shuki25/smart-chessboard-controller/pdf/smart-chessboard-controller.pdf

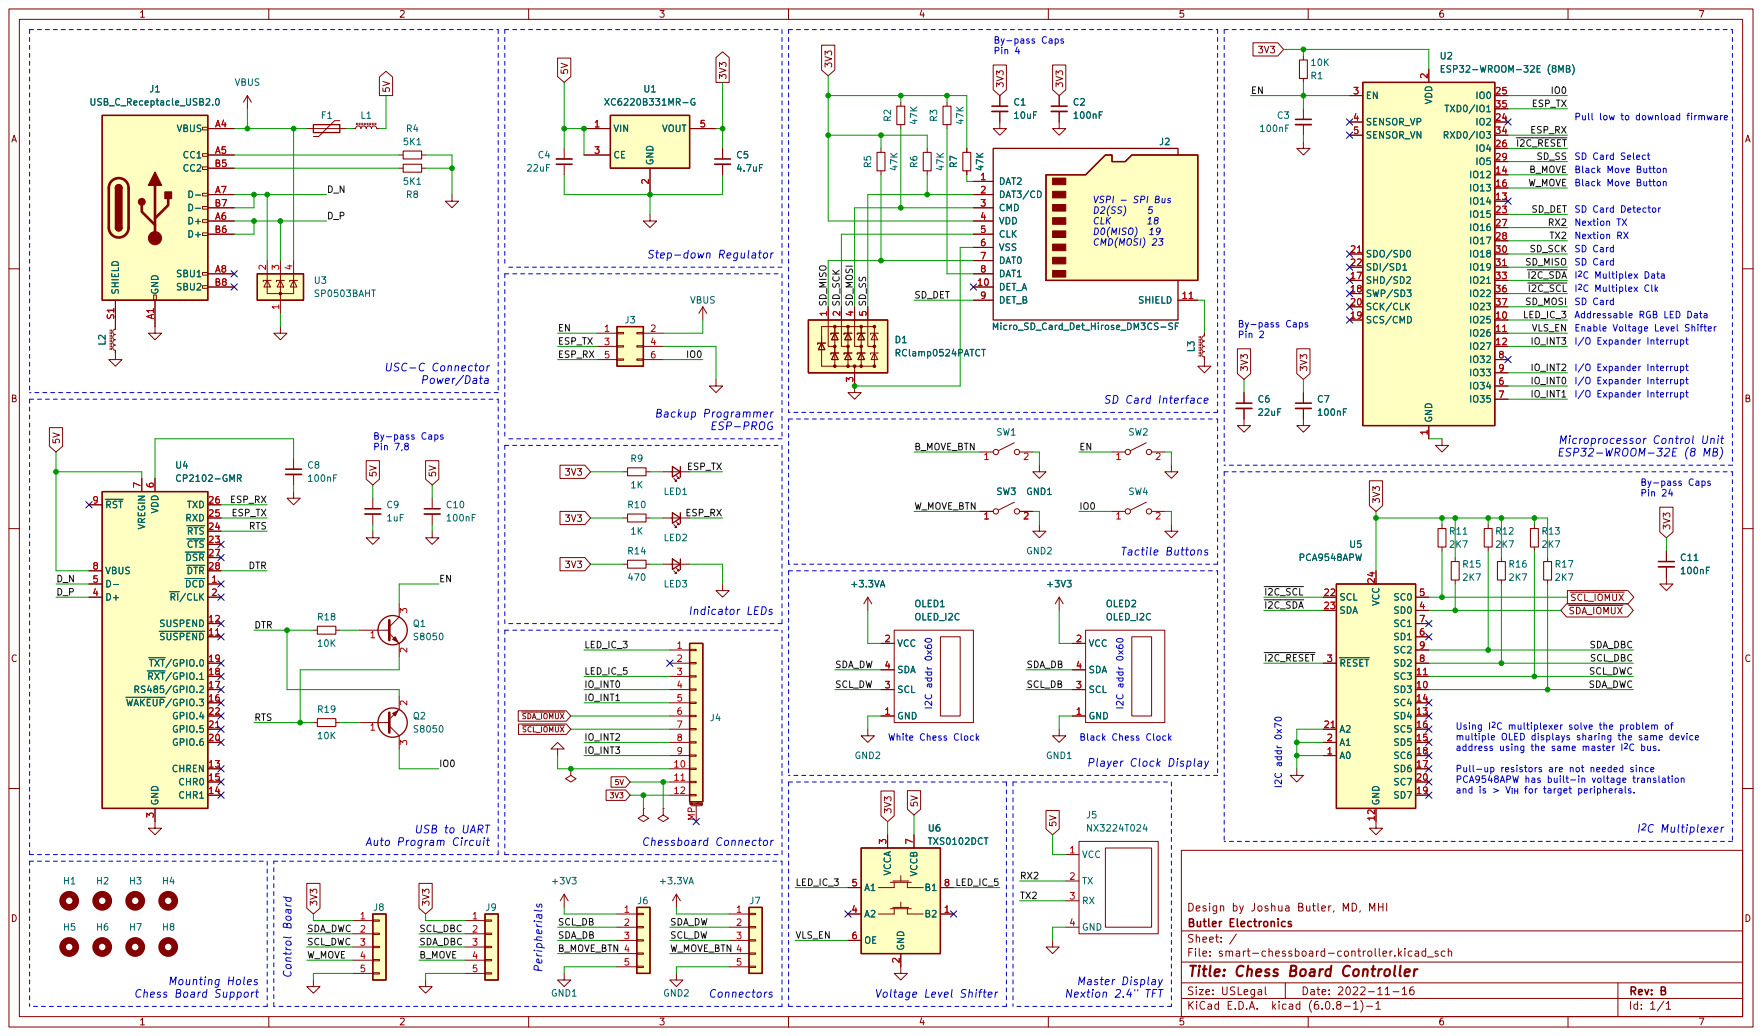
[picture p1: page 1]

2 SCK/CLK 20 SDO/SD0 21 SDI/SD1 22

By-pass Caps Pin 24 Black Move Button I2C addr 0x60

SD Card Chessboard Connector
Step-down Regulator

4 U3SP0503BAHT A0 1 SD3 10 SC3 11 GND 12 SD4 13 SC4 14 SD5 15 SC5 16 SD6 17 SC6 18 SD7 19 A1 2 SC7 20 A2 21 SCL 22 SDA 23 VCC 24

I^{2}C Multiplex Clk
I/O Expander Interrupt SD Card

Enable Voltage Level Shifter
I/O Expander Interrupt

Backup Programmer ESP-PROG

7 B1 8 OLED1 OLED_I2C GND 1 VCC 2 SCL 3 SDA 4 U5 PCA9548APW
+3.3VA GND2

IO_INT3 EN

Using I^{2}C multiplexer solve the problem of
multiple OLED displays sharing the same device
address using the same master I^{2}C bus.

Pull-up resistors are not needed since
PCA9548APW has built-in voltage translation
and is > V_{iH} for target peripherals.

Chess Board Support | +3V3

D Date: 2022-11-16 KiCad E.D.A. kicad (6.0.8-1)-1
File: smart-chessboard-controller.kicad_sch Sheet: / Butler Electronics

Id: 1/1 Title: Chess Board Controller
