shuki25/smart-chessboard-controller/smart-chessboard-controller.kicad_pcb

## KiCad design smart-chessboard-controller.kicad_pcb (2022-12-08)

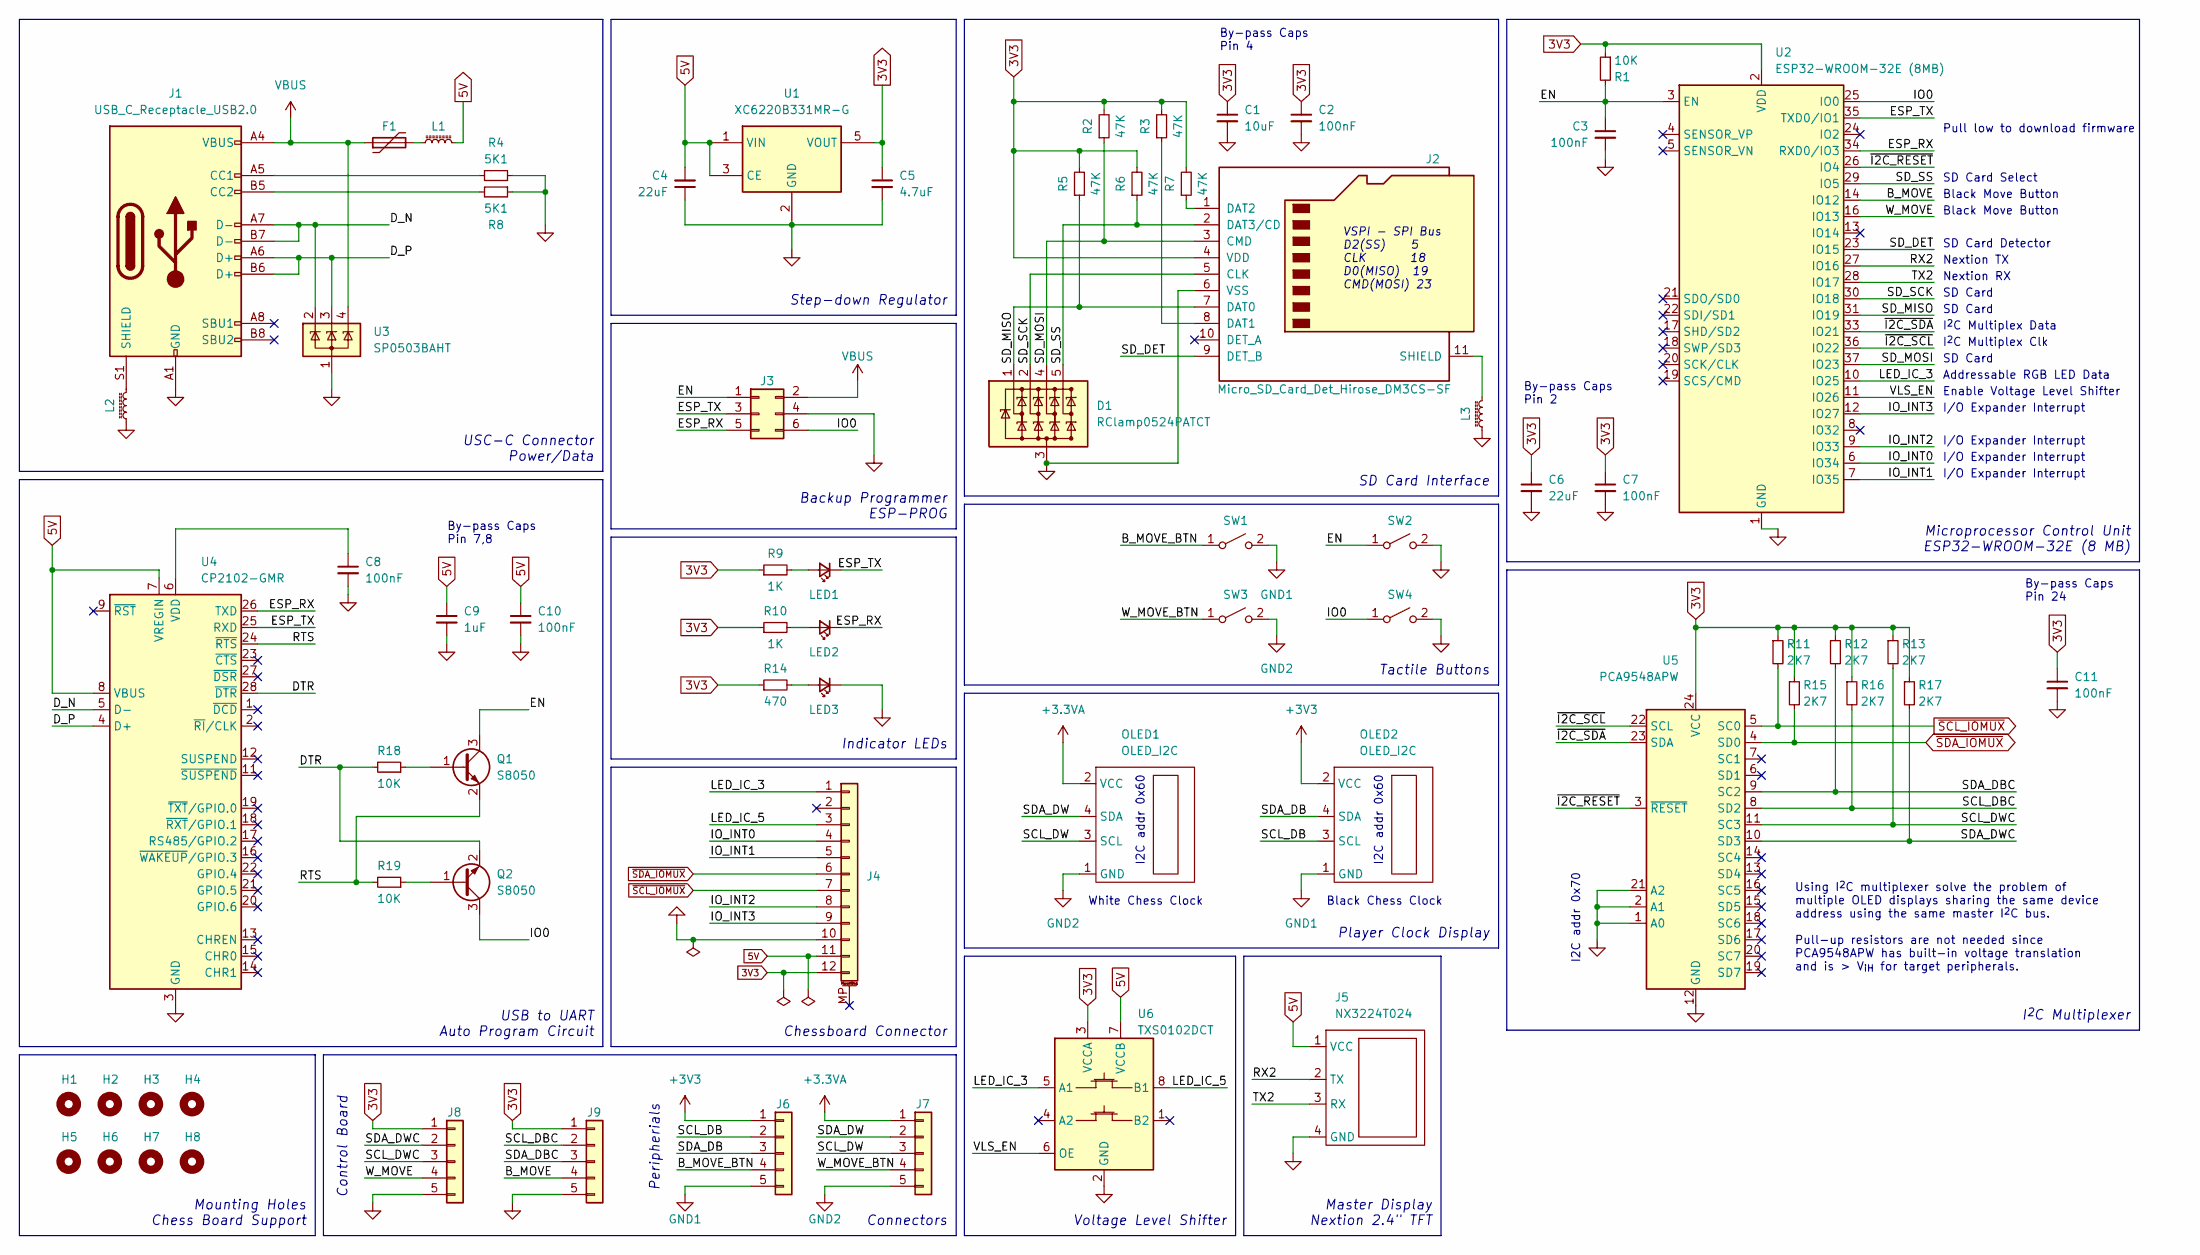
[picture p2: schematic smart-chessboard-controller.kicad_sch, Chess Board Controller]

Parts:
C1: 10uF; C_0603_1608Metric; LCSC C19702
C2, C3, C7, C8, C10, C11: 100nF; C_0603_1608Metric; LCSC C14663
C4, C6: 22uF; C_0603_1608Metric; LCSC C59461
C5: 4.7uF; C_0603_1608Metric; LCSC C19666
C9: 1uF; C_0603_1608Metric; LCSC C14663
D1: RClamp0524PATCT; SLP2510P8; LCSC C40960
F1: C207047; Fuse_1210_3225Metric; LCSC C135353
H1, H2, H3, H4, H5, H6, H7, H8: MountingHole; MountingHole_2.7mm_M2.5_DIN965_Pad_TopBottom
J1: USB_C_Receptacle_USB2.0; USB_C_Receptable_918-418K2023S40001; LCSC C167321
J2: Micro_SD_Card_Det_Hirose_DM3CS-SF; DM3CS-SF; LCSC C202111
J3: Conn_02x03_Odd_Even; TC2030-IDC-NL
J4: Conn_01x12_MountingPin; TE_1-84953-2_1x12-1MP_P1.0mm_Horizontal; LCSC C262718
J5: NX3224T024; JST_PH_S4B-PH-K_1x04_P2.00mm_Horizontal; LCSC C157926
J6, J7, J8, J9: Conn_01x05; JST_PH_S5B-PH-K_1x05_P2.00mm_Horizontal; LCSC C157923
L1: L_Ferrite_Small; L_0805_2012Metric_Pad1.15x1.40mm_HandSolder; LCSC C61012
L2, L3: L_Ferrite_Small; L_0603_1608Metric; LCSC C113018
LED1: BLUE; LED_0603_1608Metric; LCSC C72041
LED2: GREEN; LED_0603_1608Metric; LCSC C72043
LED3: RED; LED_0603_1608Metric; LCSC C2286
OLED1, OLED2: OLED_I2C; OLED_128x32_I2C_4pins
Q1, Q2: S8050; SOT-23; LCSC C2146
R1, R18, R19: 10K; R_0603_1608Metric; LCSC C25804
R2, R3, R5, R6, R7: 47K; R_0603_1608Metric; LCSC C25819
R4, R8: 5K1; R_0805_2012Metric; LCSC C27834
R9, R10: 1K; R_0603_1608Metric; LCSC C21190
R11, R12, R13, R15, R16, R17: 2K7; R_0603_1608Metric; LCSC C13167
R14: 470; R_0603_1608Metric; MFR_PART_NBR 0805W8F4700T5E; LCSC C23179
SW1, SW3: SW_SPST; Button_SW_12mm_1.8mm_hole; LCSC C84931
SW2, SW4: SW_SPST; XKB-Connectivity-TS-1187A-B-A-B; LCSC C318884
U1: XC6220B331MR-G; SOT-23-5; LCSC C86534
U2: ESP32-WROOM-32E (8MB); ESP32-WROOM-32; LCSC C701342
U3: SP0503BAHT; SOT-143-4; LCSC C7074
U4: CP2102-GMR; QFN-28-1EP_5x5mm_P0.5mm_EP3.35x3.35mm; LCSC C6568
U5: PCA9548APW; TSSOP-24_4.4x7.8mm_P0.65mm; LCSC C21198
U6: TXS0102DCT; SSOP-8_2.95x2.8mm_P0.65mm; LCSC C324082

Connections:
3V3: C1.1, C2.1, C5.1, C6.1, C7.1, C11.1, J2.4 (VDD), J4.12, J8.1, J9.1, R1.1, R2.2, R3.2, R5.2, R6.2, R7.2, R9.1, R10.1, R11.1, R12.1, R13.1, R14.1, R15.1, R16.1, R17.1, U1.5 (VOUT), U2.2 (VDD), U5.24 (VCC), U6.3 (VCCA)
5V: C4.2, C9.1, C10.1, J4.11, J5.1 (VCC), L1.2, U1.1 (VIN), U1.3 (CE), U4.7 (VREGIN), U4.8 (VBUS), U6.7 (VCCB)
+3.3VA: J7.1, OLED1.2 (VCC)
+3V3: J6.1, OLED2.2 (VCC)
/B_MOVE: J9.4, U2.14 (IO12)
/B_MOVE_BTN: J6.4, SW1.1 (A)
/DTR: Q2.2 (E), R18.2, U4.28 (~DTR)
/D_N: J1.A7 (D-), J1.B7 (D-), U3.2 (K), U4.5 (D-)
/D_P: J1.A6 (D+), J1.B6 (D+), U3.3 (K), U4.4 (D+)
/EN: C3.1, J3.1, Q1.3 (C), R1.2, SW2.1 (A), U2.3 (EN)
/ESP_RX: J3.5, LED2.1 (K), U2.34 (RXD0/IO3), U4.26 (TXD)
/ESP_TX: J3.3, LED1.1 (K), U2.35 (TXD0/IO1), U4.25 (RXD)
/IO0: J3.6, Q2.3 (C), SW4.1 (A), U2.25 (IO0)
/IO_INT0: J4.4, U2.6 (IO34)
/IO_INT1: J4.5, U2.7 (IO35)
/IO_INT2: J4.8, U2.9 (IO33)
/IO_INT3: J4.9, U2.12 (IO27)
/LED_IC_3: J4.1, U2.10 (IO25), U6.5 (A1)
/LED_IC_5: J4.3, U6.8 (B1)
/RTS: Q1.2 (E), R19.2, U4.24 (~RTS)
/RX2: J5.2 (TX), U2.27 (IO16)
/SCL_DB: J6.2, OLED2.3 (SCL)
/SCL_DBC: J9.2, R16.2, U5.8 (SD2)
/SCL_DW: J7.3, OLED1.3 (SCL)
/SCL_DWC: J8.3, R13.2, U5.11 (SC3)
/SDA_DB: J6.3, OLED2.4 (SDA)
/SDA_DBC: J9.3, R12.2, U5.9 (SC2)
/SDA_DW: J7.2, OLED1.4 (SDA)
/SDA_DWC: J8.2, R17.2, U5.10 (SD3)
/SD_DET: J2.9 (DET_B), U2.23 (IO15)
/SD_MISO: D1.1 (K1), J2.7 (DAT0), R5.1, U2.31 (IO19)
/SD_MOSI: D1.4 (K3), J2.3 (CMD), R2.1, U2.37 (IO23)
/SD_SCK: D1.2 (K2), J2.5 (CLK), U2.30 (IO18)
/SD_SS: D1.5 (K4), J2.2 (DAT3/CD), R6.1, U2.29 (IO5)
/TX2: J5.3 (RX), U2.28 (IO17)
/VLS_EN: U2.11 (IO26), U6.6 (OE)
/W_MOVE: J8.4, U2.16 (IO13)
/W_MOVE_BTN: J7.4, SW3.1 (A)
/~I2C_RESET: U2.26 (IO4), U5.3 (~RESET)
/~I2C_SCL: U2.36 (IO22), U5.22 (SCL)
/~I2C_SDA: U2.33 (IO21), U5.23 (SDA)
GND: C1.2, C2.2, C3.2, C4.1, C5.2, C6.2, C7.2, C8.2, C9.2, C10.2, C11.2, D1.3 (A), J1.A1 (GND), J1.A12 (GND), J1.B1 (GND), J1.B12 (GND), J2.6 (VSS), J3.4, J4.10, J5.4 (GND), J8.5, J9.5, L2.1, L3.1, LED3.1 (K), R4.1, R8.1, SW2.2 (B), SW4.2 (B), U1.2 (GND), U2.1 (GND), U2.15 (GND), U2.38 (GND), U2.39 (GND), U3.1 (A), U4.3 (GND), U4.29 (GND), U5.1 (A0), U5.2 (A1), U5.12 (GND), U5.21 (A2), U6.2 (GND)
GND1: J6.5, OLED2.1 (GND), SW1.2 (B)
GND2: J7.5, OLED1.1 (GND), SW3.2 (B)
unnamed: C8.1, U4.6 (VDD)
unnamed: F1.2, L1.1
unnamed: J1.A5 (CC1), R4.2
unnamed: J1.B5 (CC2), R8.2
unnamed: J1.S1 (SHIELD), L2.2
unnamed: J2.1 (DAT2), R7.1
unnamed: J2.8 (DAT1), R3.1
unnamed: J2.11 (SHIELD), L3.2
unnamed: LED1.2 (A), R9.2
unnamed: LED2.2 (A), R10.2
unnamed: LED3.2 (A), R14.2
unnamed: Q1.1 (B), R18.1
unnamed: Q2.1 (B), R19.1
VBUS: F1.1, J1.A4 (VBUS), J1.A9 (VBUS), J1.B4 (VBUS), J1.B9 (VBUS), J3.2, U3.4 (K)
~SCL_IOMUX: J4.7, R11.2, U5.5 (SC0)
~SDA_IOMUX: J4.6, R15.2, U5.4 (SD0)

Notes on the sheet:
SD Card
I/O Expander Interrupt
USB to UART Auto Program Circuit
I^{2}C Multiplex Clk
Voltage Level Shifter
SD Card Detector
Master Display Nextion 2.4" TFT
By-pass Caps Pin 4
Chessboard Connector
Nextion RX
Microprocessor Control Unit ESP32-WROOM-32E (8 MB)
USC-C Connector Power/Data
SD Card Interface
Player Clock Display
Black Move Button
I^{2}C Multiplex Data
Control Board
I^{2}C Multiplexer
Addressable RGB LED Data
Black Chess Clock
By-pass Caps Pin 24
By-pass Caps Pin 7,8
I2C addr 0x60
White Chess Clock
By-pass Caps Pin 2
Enable Voltage Level Shifter
I2C addr 0x70
Peripherials
VSPI - SPI Bus D2(SS) 5 CLK 18 D0(MISO) 19 CMD(MOSI) 23
Step-down Regulator
Backup Programmer ESP-PROG
Pull low to download firmware
Connectors
Using I^{2}C multiplexer solve the problem of multiple OLED displays sharing the same device address using the same master I^{2}C bus. Pull-up resistors are not needed since PCA9548APW has built-in voltage translation and is > V_{iH} for target peripherals.
Nextion TX
Mounting Holes Chess Board Support
Indicator LEDs
Tactile Buttons
SD Card Select

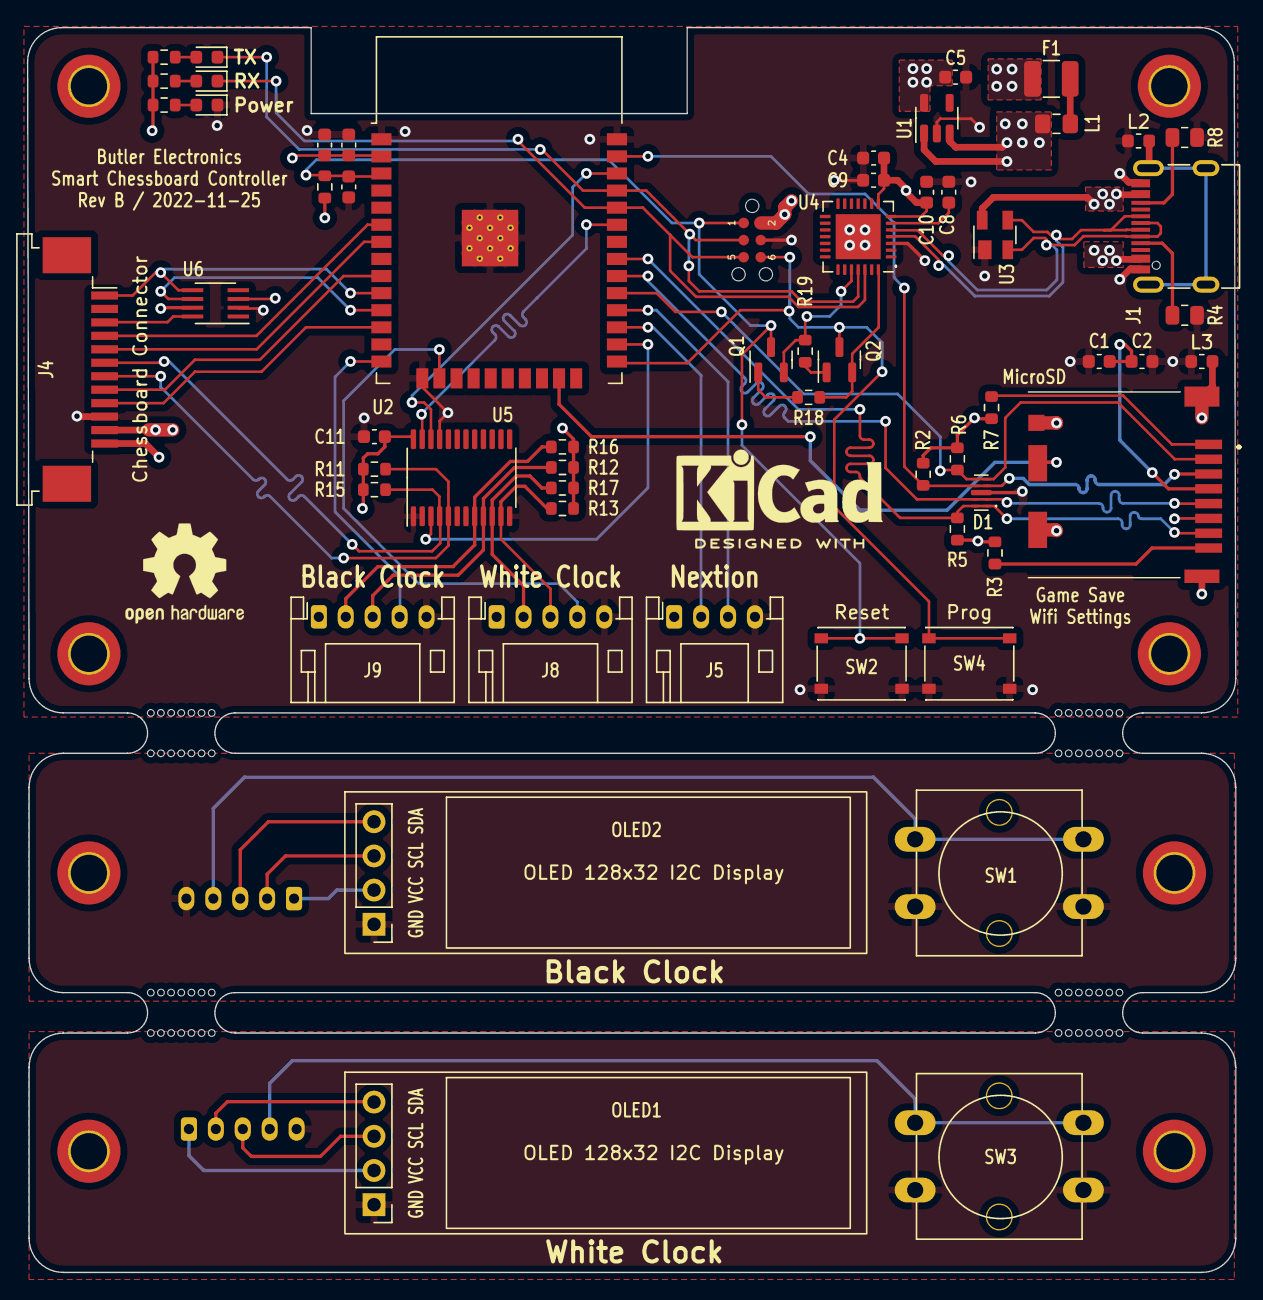
[picture p3: board smart-chessboard-controller.kicad_pcb from above]

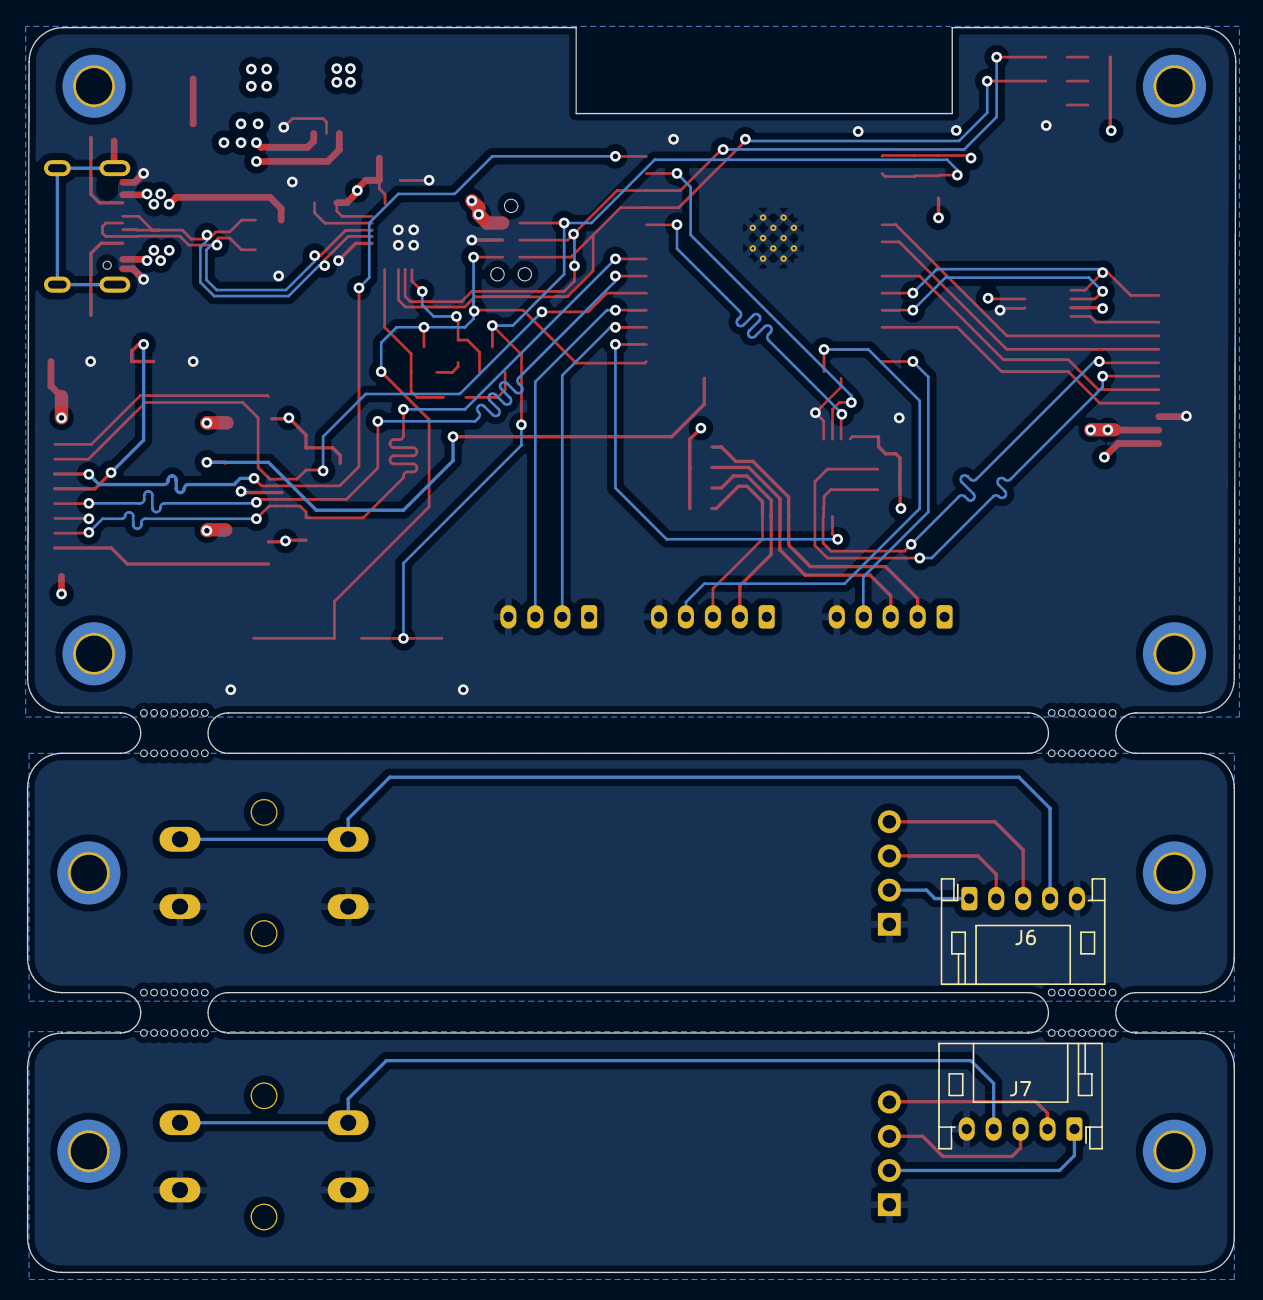
[picture p4: board smart-chessboard-controller.kicad_pcb from below]

Board: 4 copper layers, 89.8 x 92.5 mm, 73 parts (2 on the bottom side), 60 nets.

Other parts of the board:
mouse-bite-3mm-slot, mouse-bite-3mm-slot#2, mouse-bite-3mm-slot#3, mouse-bite-3mm-slot#4: VAL**; mouse-bite-3mm-slot
