shuki25/smart-chessboard-controller/(commit log)

2022-11-18 update layout
    [smart-chessboard-controller.kicad_pcb]
2022-11-18 move around pins on ESP32 to optimize PCB layout
    [smart-chessboard-controller.kicad_sch]
2022-11-18 change mounting hole size
    [smart-chessboard-controller.kicad_pcb, smart-chessboard-controller.kicad_sch]
2022-11-18 add some traces
    [smart-chessboard-controller.kicad_pcb]
2022-11-21 add all traces and power traces
    [smart-chessboard-controller.kicad_pcb, smart-chessboard-controller.kicad_sch]
2022-11-21 add logos and fix DRC issues
    [smart-chessboard-controller.kicad_pcb]
2022-11-21 refactor LDO layout
    [smart-chessboard-controller.kicad_pcb]
2022-11-21 update labels
    [smart-chessboard-controller.kicad_sch]
2022-11-25 move usb-c to the side of the pcb
    - revise ground nets for clock boards
    - add backup led IC data line if the voltage regulator fails
    [smart-chessboard-controller.kicad_pcb, smart-chessboard-controller.kicad_sch]
2022-11-25 update manufacturing files
    [smart-chessboard-controller-CuBottom.gbr, smart-chessboard-controller-CuIn1.gbr, smart-chessboard-controller-CuIn2.gbr, smart-chessboard-controller-CuTop.gbr, smart-chessboard-controller-EdgeCuts.gbr, smart-chessboard-controller-MaskBottom.gbr, smart-chessboard-controller-MaskTop.gbr, smart-chessboard-controller-NPTH.drl]
2022-11-25 tune i2c trace length
    [smart-chessboard-controller.kicad_pcb]
2022-12-08 update production files
    [smart-chessboard-controller-CuBottom.gbr, smart-chessboard-controller-CuIn1.gbr, smart-chessboard-controller-CuIn2.gbr, smart-chessboard-controller-CuTop.gbr, smart-chessboard-controller-EdgeCuts.gbr, smart-chessboard-controller-MaskBottom.gbr, smart-chessboard-controller-MaskTop.gbr, smart-chessboard-controller-NPTH.drl]
2022-12-08 update USB-C footprint to through hole
    [smart-chessboard-controller.kicad_pcb]
2022-12-27 update schematic pdf
